ryood/SPI_Wein_Bridge_Osc/AD8402_WeinBridge_DCO_出力振幅.png

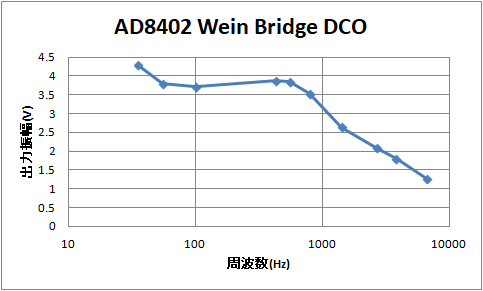
AD8402_WeinBridge_DCO_出力振幅.png
