ryood/SPI_Wein_Bridge_Osc/eagle/AD8402_WeinBridge_DCO_brd.png

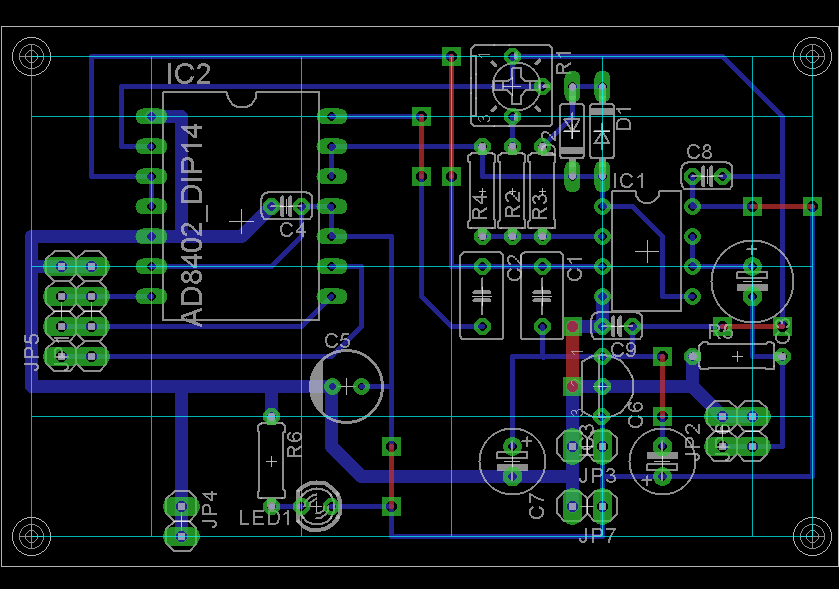
eagle/AD8402_WeinBridge_DCO_brd.png
