ryood/SPI_Wein_Bridge_Osc/eagle/AD8402_WeinBridge_DCO_sch.png

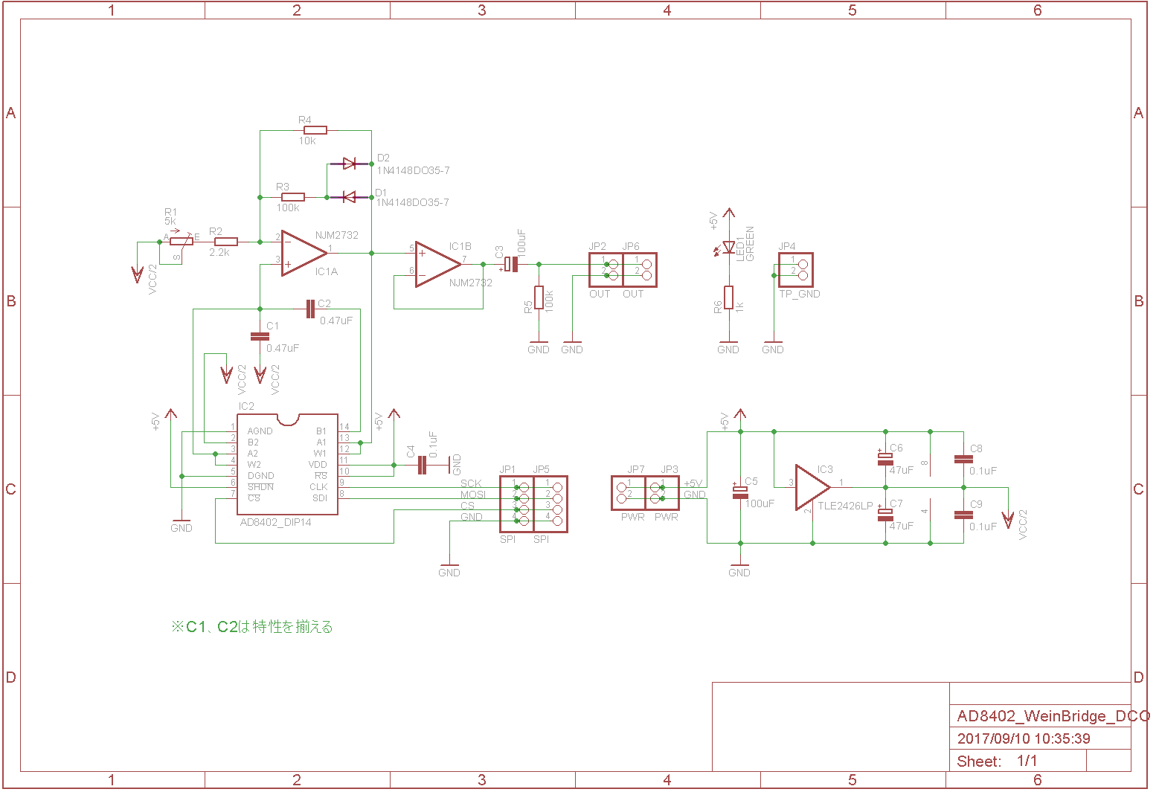
eagle/AD8402_WeinBridge_DCO_sch.png
