ryood/SPI_Wein_Bridge_Osc/fritzing/Wein Bridge_NJM2137_AD8403_10ohm_ブレッドボード.png

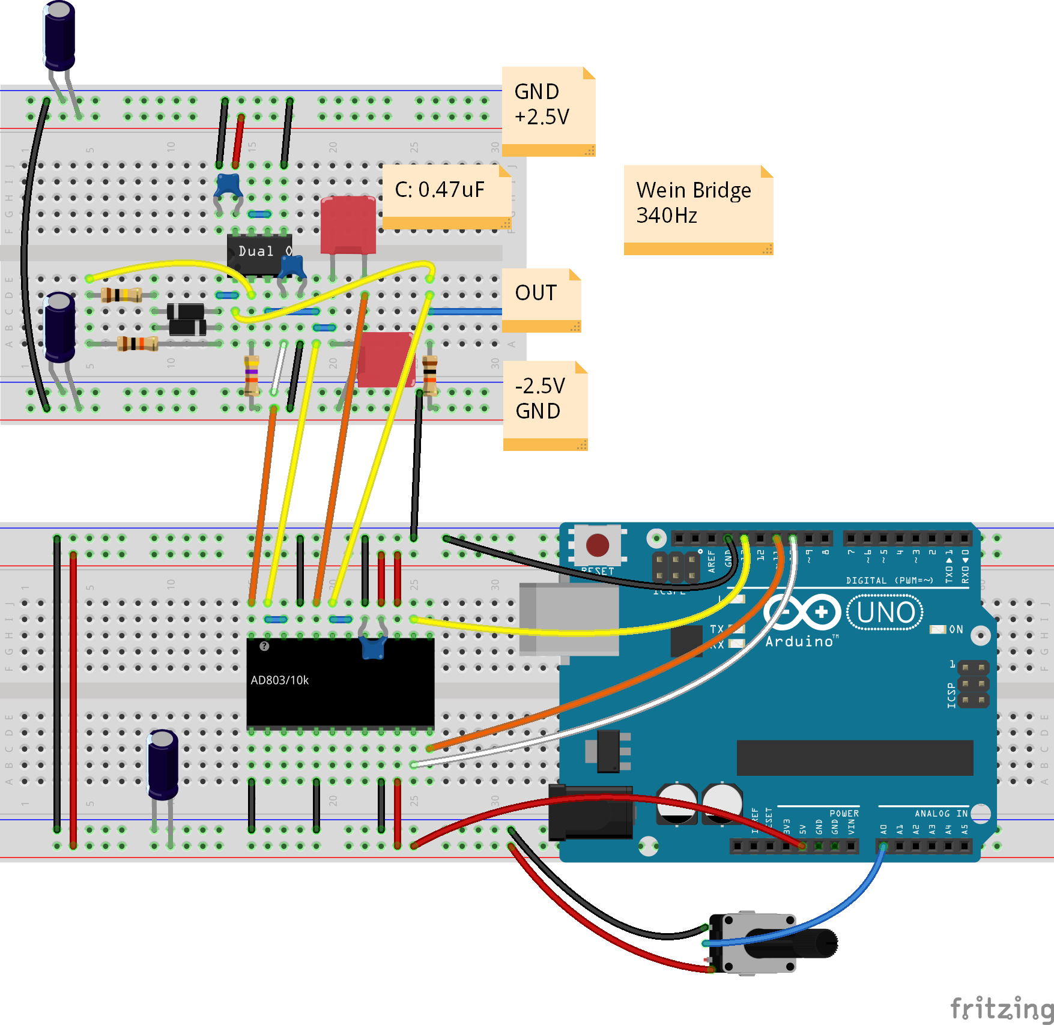
fritzing/Wein Bridge_NJM2137_AD8403_10ohm_ブレッドボード.png
