ryood/SPI_Wein_Bridge_Osc/fritzing/Wein Bridge_NJM2137_ブレッドボード.png

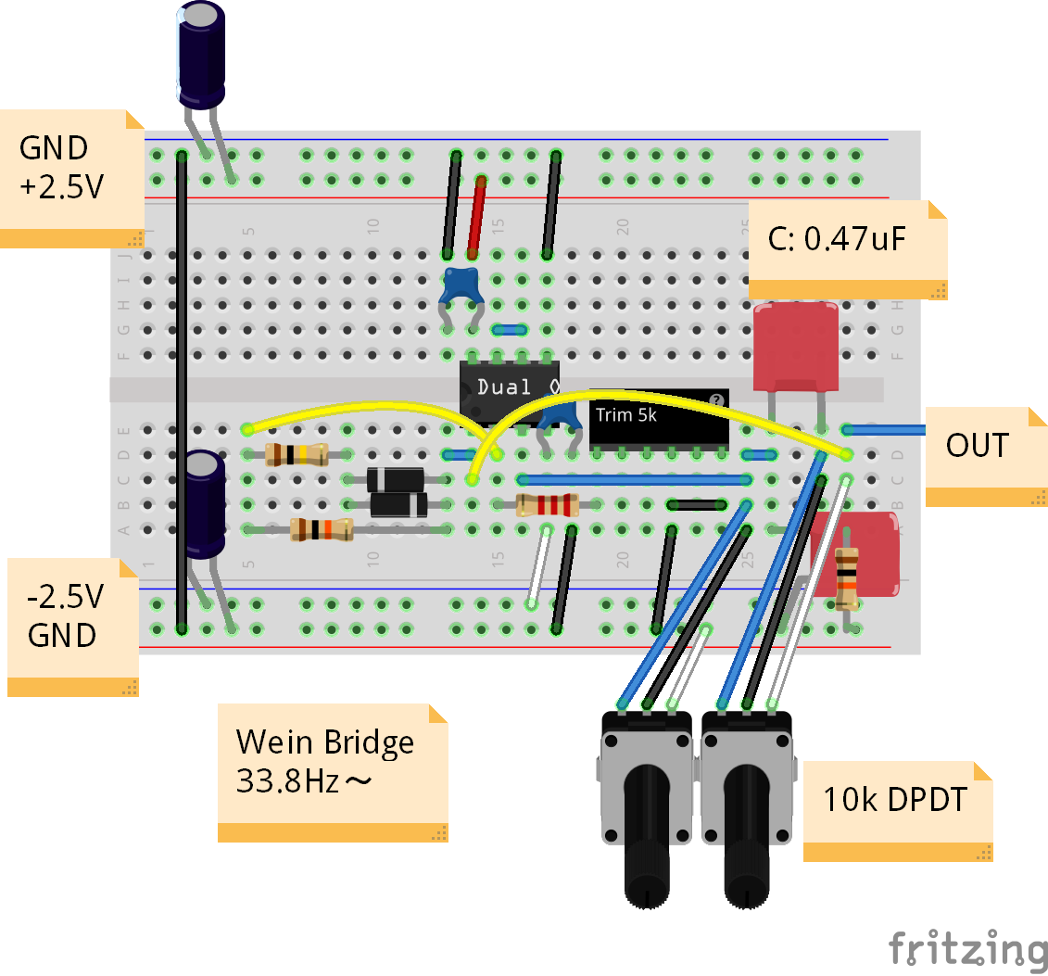
fritzing/Wein Bridge_NJM2137_ブレッドボード.png
