ryood/SPI_Wein_Bridge_Osc/抵抗値vs発振周波数.png

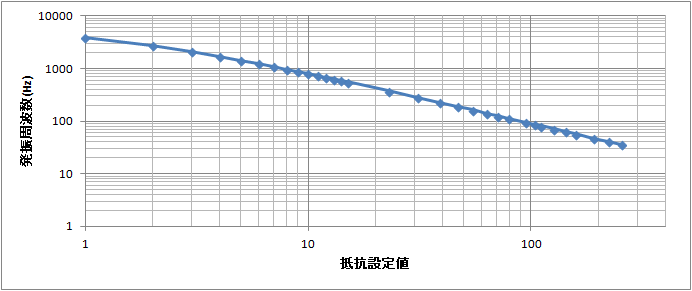
抵抗値vs発振周波数.png
