ryood/SPI_Wein_Bridge_Osc/発振周波数vs振幅.png

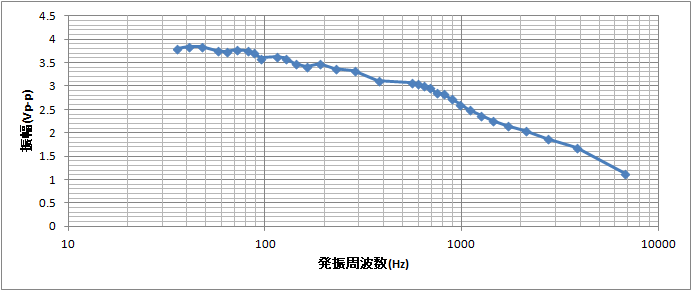
発振周波数vs振幅.png
