ryood/SPI_Wein_Bridge_Osc/spice/Wien bridge NJM2732freq.asc

C1: cap; 0.47u
C2: cap; 0.47u
D1: diode
D2: diode
R1: res; 4.7k
R2: res; 100k
R3: res; 10k
R4: res; {Rf}
R5: res; {Rf}
U1: opamp2; njm2732_S
V1: voltage; 2.5V
V2: voltage; -2.5V
Named nets: 0, VCC, VEE, OUT
.tran 0 1000m 900m startup
.include mylib\
jm2732_2.lib
.step param Rf list 1k 5k 10k
