ryood/SPI_Wein_Bridge_Osc/(list of files, drawings)

Other design files:
fritzing/AD8402_Test.fzz
fritzing/AD8402_WeinBridge_DCO_Test.fzz
fritzing/Wein Bridge_NJM2137.fzz
fritzing/Wein Bridge_NJM2137_AD8403_10ohm.fzz
fritzing/Wein Bridge_NJM2137_AD8403_10ohm_2.fzz
fritzing/Wein Bridge_NJM2137_AD8403_10ohm_VoltageFollower.fzz
