ryood/SPI_Wein_Bridge_Osc/fritzing/AD8402_Test_ブレッドボード.png

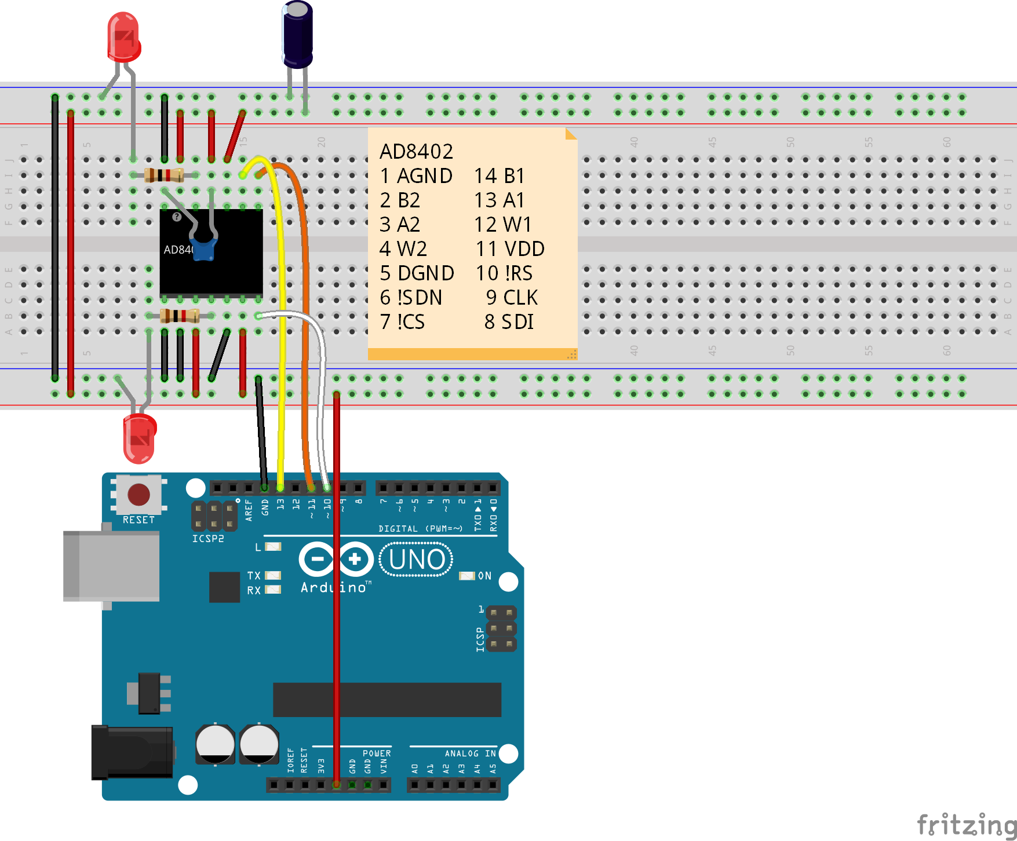
fritzing/AD8402_Test_ブレッドボード.png
