ryood/SPI_Wein_Bridge_Osc/(commit log)

2017-09-01 Add fritzing files using AD8402
    [AD8402_Test.fzz, AD8402_WeinBridge_DCO_Test.fzz, Wein Bridge_NJM2137_AD8403_10ohm_2.fzz, Wein Bridge_NJM2137_AD8403_10ohm_VoltageFollower.fzz]
2017-09-01 Add a ealge project of AD8402_WeinBridge_DCO
    [AD8402_WeinBridge_DCO.sch]
2017-09-03 Before Routing Board Design
    [AD8402 Wein Bidge DCO.xlsx, AD8402_WeinBridge_DCO.brd, AD8402_WeinBridge_DCO.sch, AD8402_WeinBridge_DCO_Test.fzz]
2017-09-13 Update eagle files
    [AD8402_WeinBridge_DCO.brd, AD8402_WeinBridge_DCO.sch]
2017-09-13 Add some files
    [AD8402_WeinBridge_DCO_発振周波数_出力振幅.xlsx]
2017-09-13 Add a test chart.
    [AD8402_WeinBridge_DCOテスト表.xlsx]
2017-09-15 Update Test Chart
    [AD8402_WeinBridge_DCOテスト表.xlsx]
